adrianocprado/Comunica-o-Assistiva/docs/imagens/esp32.jpg

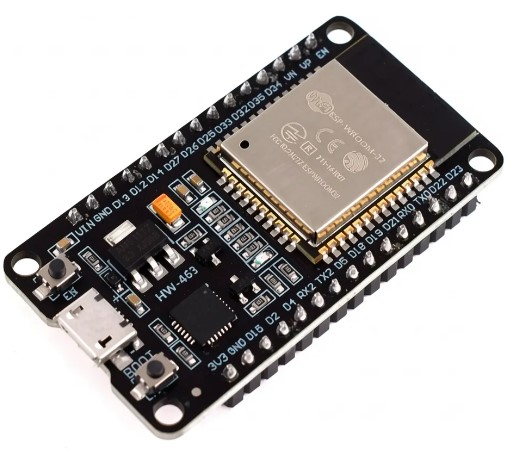
docs/imagens/esp32.jpg
