adrianocprado/Comunica-o-Assistiva/docs/imagens/etiquetarf.jpg

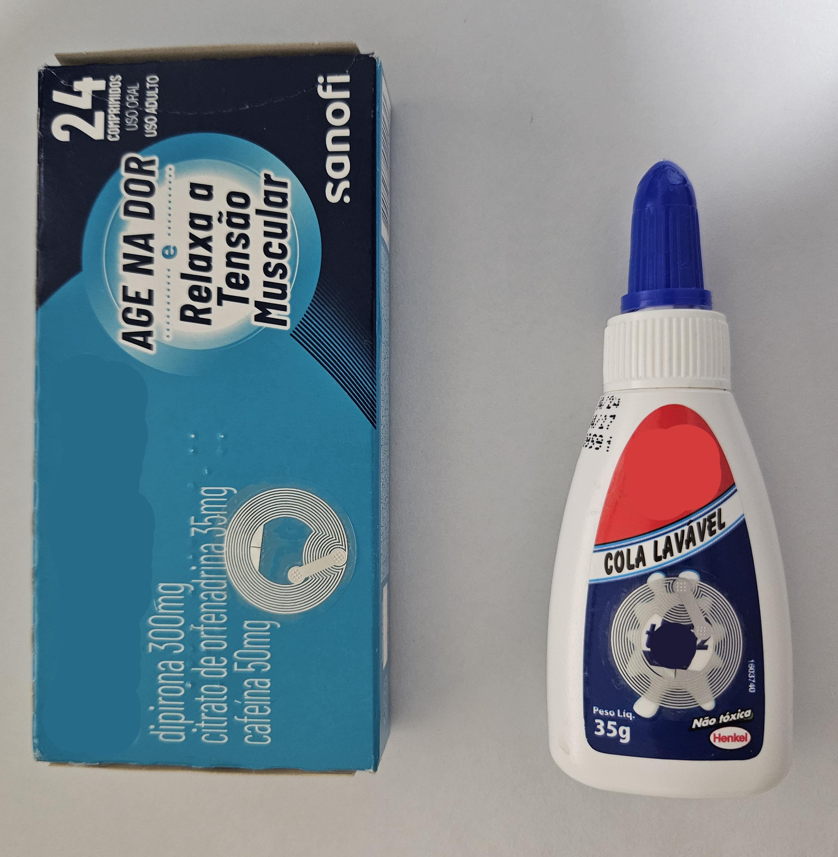
docs/imagens/etiquetarf.jpg
