adrianocprado/Comunica-o-Assistiva/docs/diagrama_esquematico_completo_j5019.pdf

# Manual Técnico e Diagrama Elétrico Unificado

Documentação de Suporte para Repositórios GitHub - Sistema Móvel Integrado

## 1. Diagrama Esquemático ASCII

O diagrama abaixo representa a integração completa entre a alimentação, gerenciamento de energia,
controle de fluxo por chave física e os módulos de processamento/periféricos do dispositivo.

======================================================================================== DIAGRAMA DE FLUXO ELÉTRICO COMPLETO — ECOSSISTEMA PORTÁTIL UNIFICADO ========================================================================================

[ ENTRADA DE ENERGIA ]
│
├──► (Via Cabo) ──────► [ Porta USB Tipo-C Integrada na Placa ]
| | │ | | | │
└──► (Alternativa) ───► [ Terminais IN+ / IN- ]
| | | | | │ ▼

┌────────────────────────────────────────────────────────────────────────────────┐
│ | MÓDULO INTEGRADO J5019 | │
│ | | | | | | | │
│ | [ Circuito de Carga ] | [ Circuito Regulador Step-Up ] │
│ | Modo: CC/CV (4.2V Max) | Ajuste por Trimpot (Ex: 5.0V) | │
│ | | | | | | | │
│ | BAT+ | BAT- | VOUT+ | VOUT- | │
└───────┬─────────────┬────────────────────────────────┬───────────────┬─────────┘
│ | │ | │ | │
▼ | ▼ | ▼ | │
┌─────┐ | ┌─────┐ | ┌───────┐ | │
│ (+) │ | │ (-) │ | │ CHAVE │ | │
└─────┘ | └─────┘ | │ LIGA/ │ | │
[ CÉLULA BATERIA 18650 ] | │ DESL. │ | │
(Lítio-Íon - 3.7V Nominal) | └───┬───┘ | │
│ | │
▼ | ▼
( 5V+ ) | ( GND )
│ | │
┌──────────────────────────────────────────────────────┴───────────────┴─────────┐
│ SISTEMA DO DISPOSITIVO (Exemplos de Carga Utilizável) | │
│ | | | | | | | │
│ | ┌───────────────────────────┐ | ┌───────────────────────────┐ | │
│ | │ | MICROCONTROLADOR | │ | │ | MÓDULOS PERIFÉRICOS | │ | │
│ | │ (Placa Arduino / ESP32) │ | │ (Sensores, Displays, etc)│ | │
│ | │ | | │ | │ | | │ | │
│ | │ | [ PINO 5V ] | [ PINO GND] | │ | [ PINO VCC ] [ PINO GND]│ | │
│ | └───▲─────────────▲─────────┘ | └───▲────────────▲──────────┘ | │
│ | │ | │ | │ | │ | │
│ | └─────────────┼────────────────────┴────────────┤ | │
└─────────────────────┼─────────────────────────────────┼────────────────────────┘ └─────────────────────────────────┘

## 2. Detalhamento das Conexões e Barramentos

Subcircuito de Armazenamento (Lítio): Os pinos BAT+ e BAT- conectam-se diretamente às extremidades correspondentes da célula 18650. Este barramento opera de maneira segura e independente, permitindo a recarga mesmo quando o dispositivo principal estiver desligado através da chave.

Controle de Fluxo (Chave Liga/Desliga): O terminal positivo elevado VOUT+ é direcionado de forma exclusiva a um dos terminais da chave de interrupção. A saída controlada da chave distribui os 5V estabilizados para o sistema.

Distribuição Geral (GND Comum e VCC): O barramento negativo de referência (GND) é unificado a partir do pino VOUT-, conectando-se ao pino GND do microcontrolador e à referência de todos os periféricos acoplados. A linha positiva de 5V alimenta simultaneamente os circuitos lógicos.

## 3. Procedimento Operacional Obrigatório

Ajuste Prévio de Tensão: Antes de efetuar a ligação definitiva das linhas de alimentação ao microcontrolador e sensores, conecte uma fonte à entrada (ou use a bateria conectada) e, com auxílio de um multímetro posicionado na escala de Corrente Contínua (DCV) acoplado aos fios de saída, rotacione o potenciômetro metálico integrativo até estabelecer o patamar estrito de 5.0V.

Isolamento e Segurança: Verifique se todas as conexões soldadas estão devidamente protegidas com espaguete termoretrátil para mitigar riscos de curto-circuito mecânico dentro do invólucro do dispositivo.

Este arquivo foi gerado para documentação de projetos eletrônicos de código aberto. Verifique sempre as polaridades e as conexões antes de energizar o circuito.

•

•

•

1.

2.
