adrianocprado/Comunica-o-Assistiva/docs/imagens/altofalante4o3w.jpg

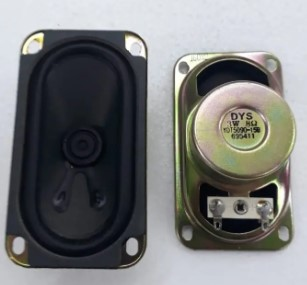
docs/imagens/altofalante4o3w.jpg
