adrianocprado/Comunica-o-Assistiva/docs/imagens/amplificadormax98357.jpg

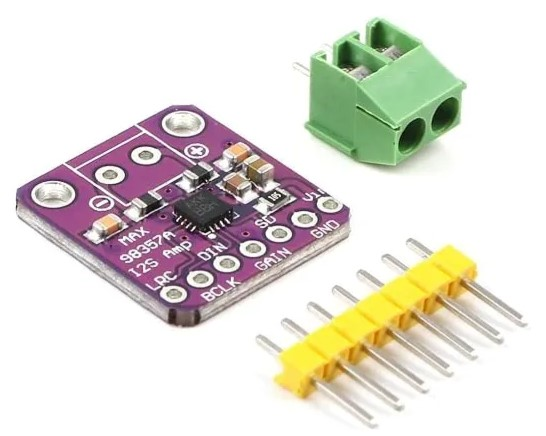
docs/imagens/amplificadormax98357.jpg
