adrianocprado/Comunica-o-Assistiva/docs/imagens/bateria18650.jpg

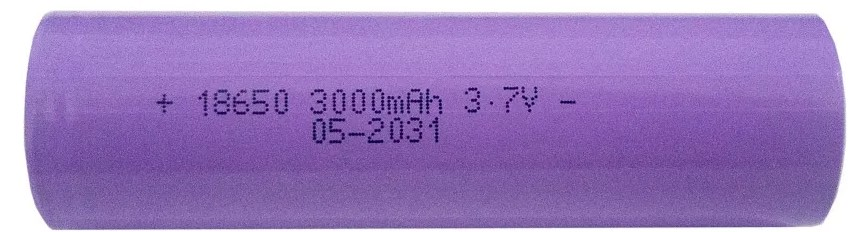
docs/imagens/bateria18650.jpg
