adrianocprado/Comunica-o-Assistiva/docs/imagens/caixa.jpg

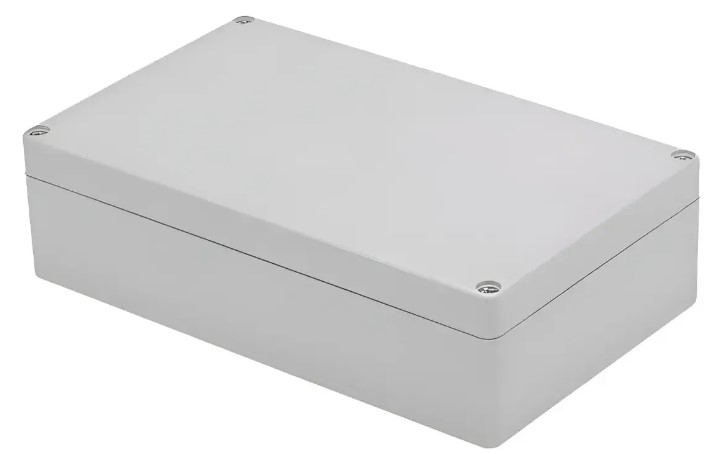
docs/imagens/caixa.jpg
