adrianocprado/Comunica-o-Assistiva/docs/imagens/cartaorfid.jpg

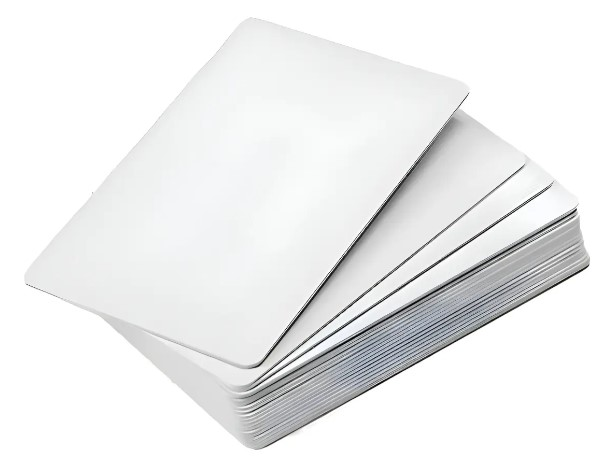
docs/imagens/cartaorfid.jpg
