adrianocprado/Comunica-o-Assistiva/docs/imagens/cartoesrfid.jpg

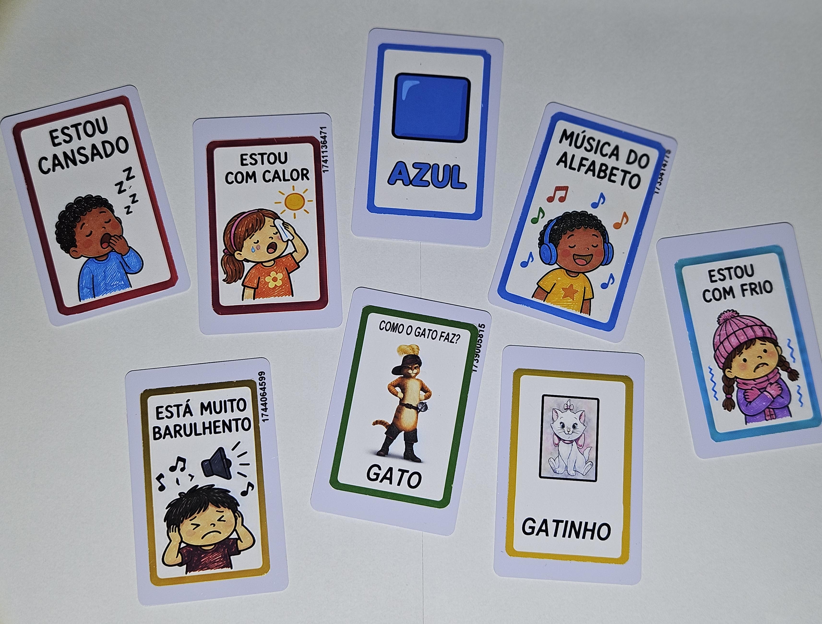
docs/imagens/cartoesrfid.jpg
