adrianocprado/Comunica-o-Assistiva/docs/imagens/chaveligadesliga.jpg

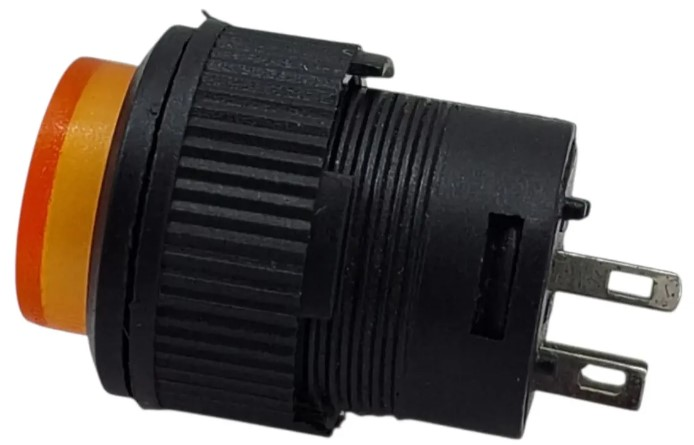
docs/imagens/chaveligadesliga.jpg
