adrianocprado/Comunica-o-Assistiva/docs/imagens/conectortipoc.jpg

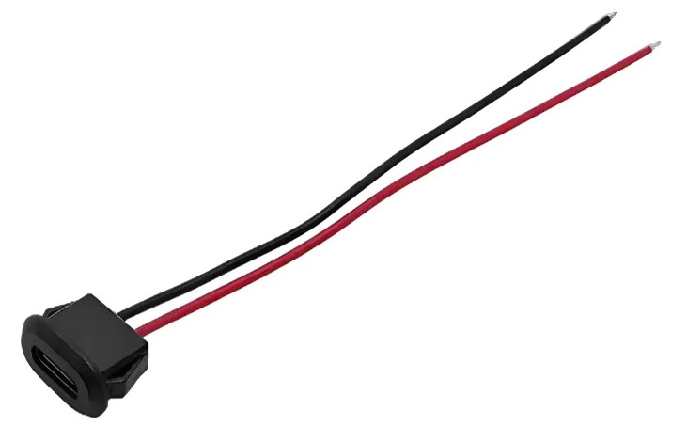
docs/imagens/conectortipoc.jpg
