adrianocprado/Comunica-o-Assistiva/docs/imagens/displaytft18.jpg

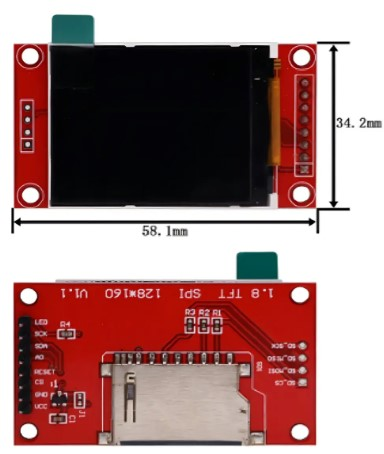
docs/imagens/displaytft18.jpg
