adrianocprado/Comunica-o-Assistiva/docs/imagens/etiquetanfc.jpg

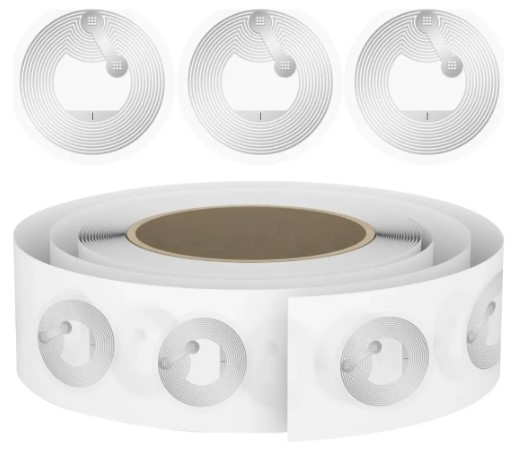
docs/imagens/etiquetanfc.jpg
