adrianocprado/Comunica-o-Assistiva/docs/imagens/ETIQUETAS.jpg

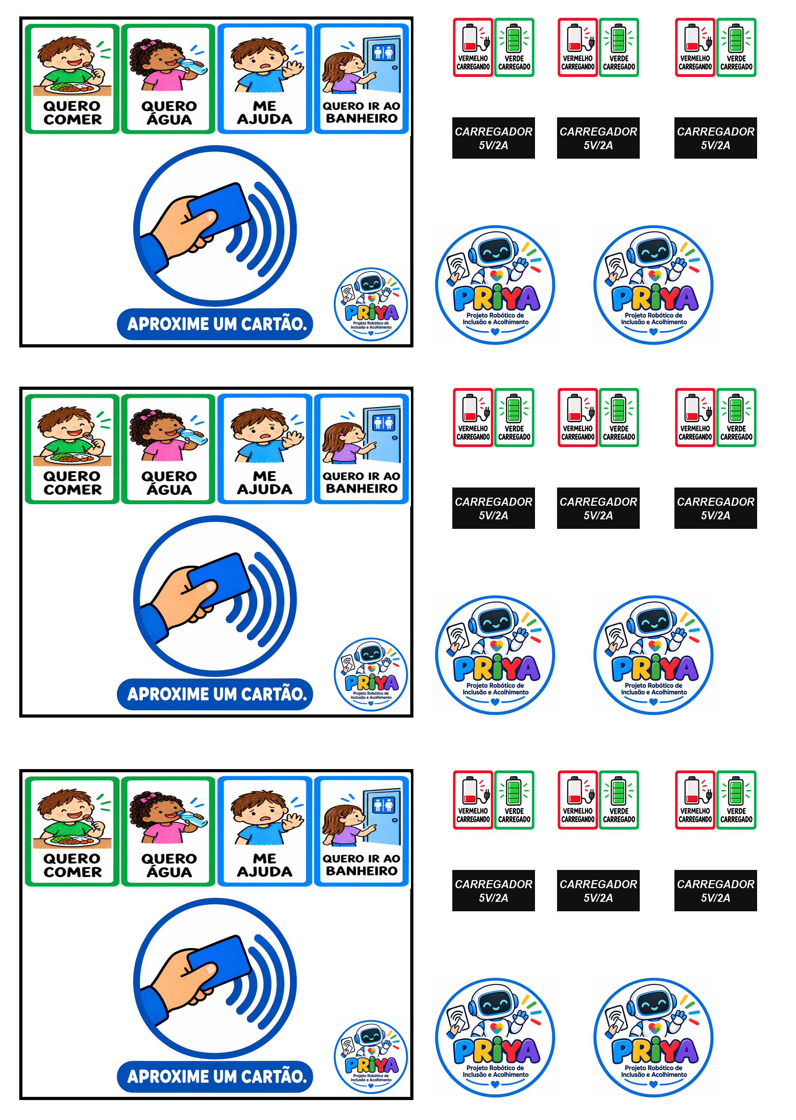
docs/imagens/ETIQUETAS.jpg
