adrianocprado/Comunica-o-Assistiva/docs/imagens/finalizado2.jpg

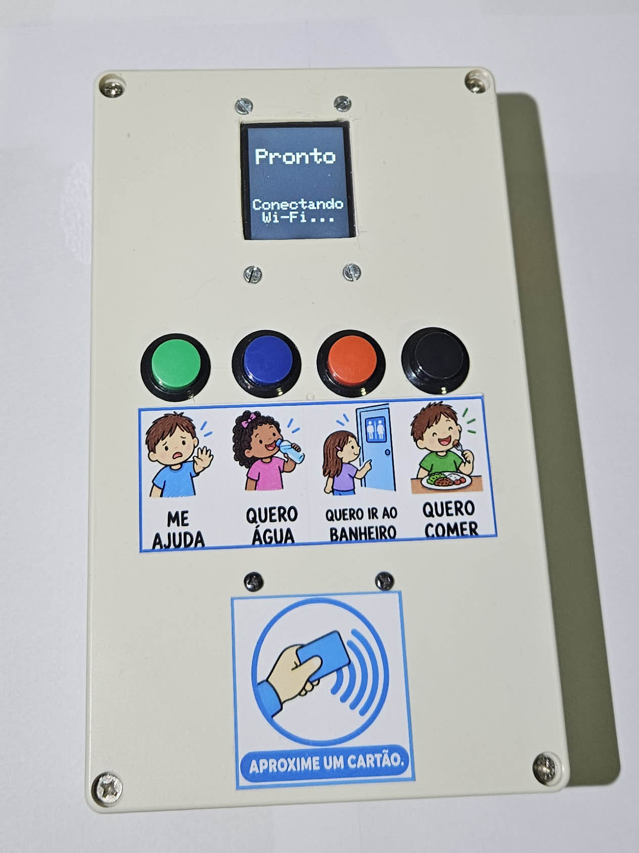
docs/imagens/finalizado2.jpg
