adrianocprado/Comunica-o-Assistiva/docs/imagens/finalizado.jpg

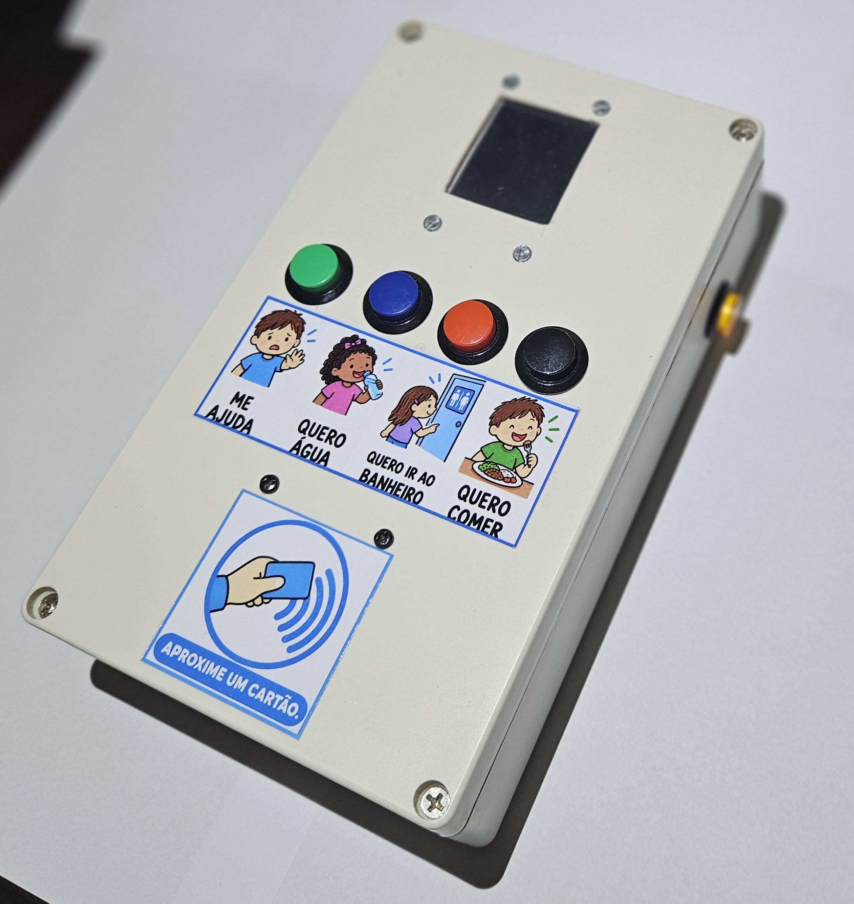
docs/imagens/finalizado.jpg
