adrianocprado/Comunica-o-Assistiva/docs/imagens/montado5.jpg

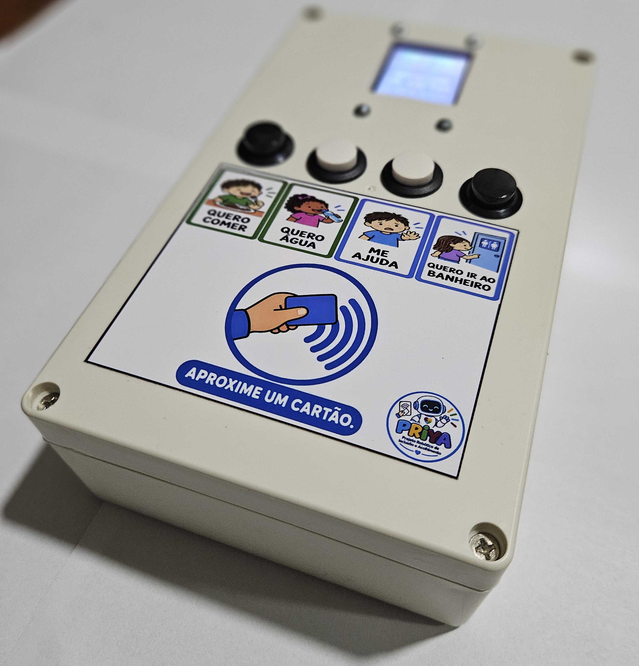
docs/imagens/montado5.jpg
