adrianocprado/Comunica-o-Assistiva/docs/imagens/montado6.jpg

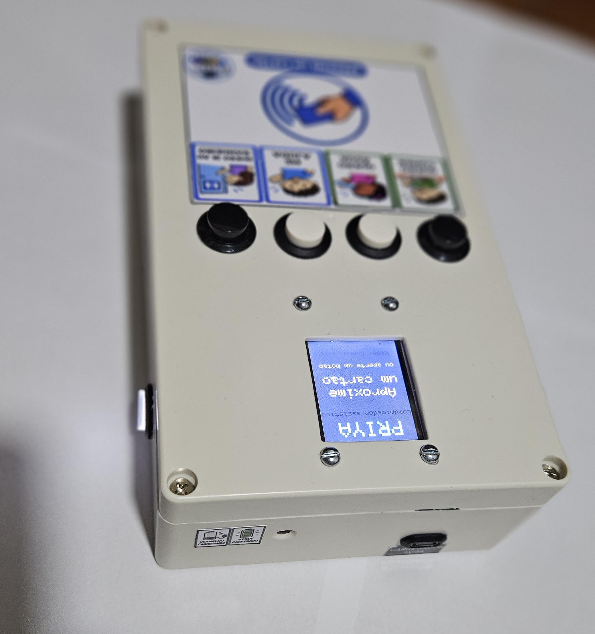
docs/imagens/montado6.jpg
