adrianocprado/Comunica-o-Assistiva/docs/imagens/montado7.jpg

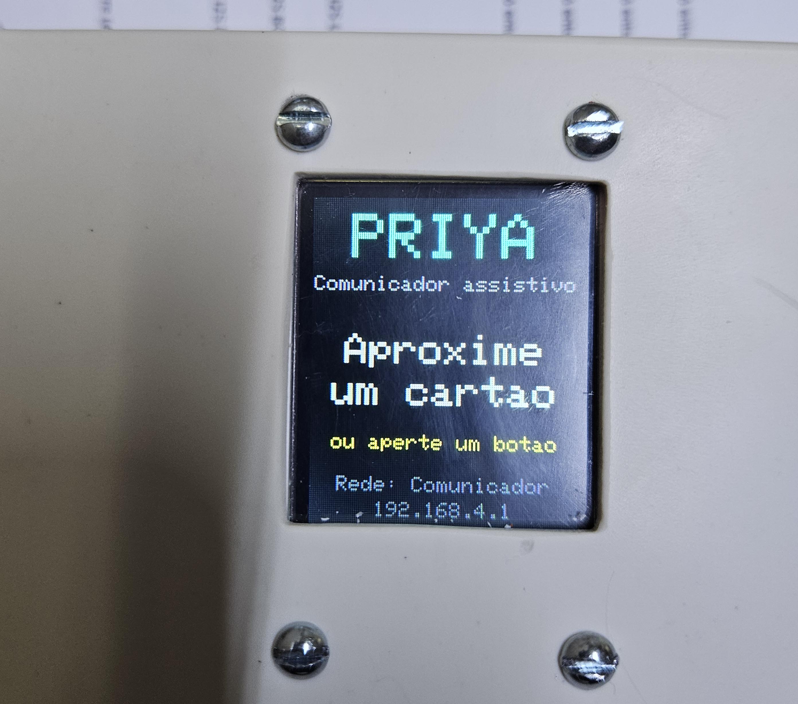
docs/imagens/montado7.jpg
