adrianocprado/Comunica-o-Assistiva/docs/imagens/montado8.jpg

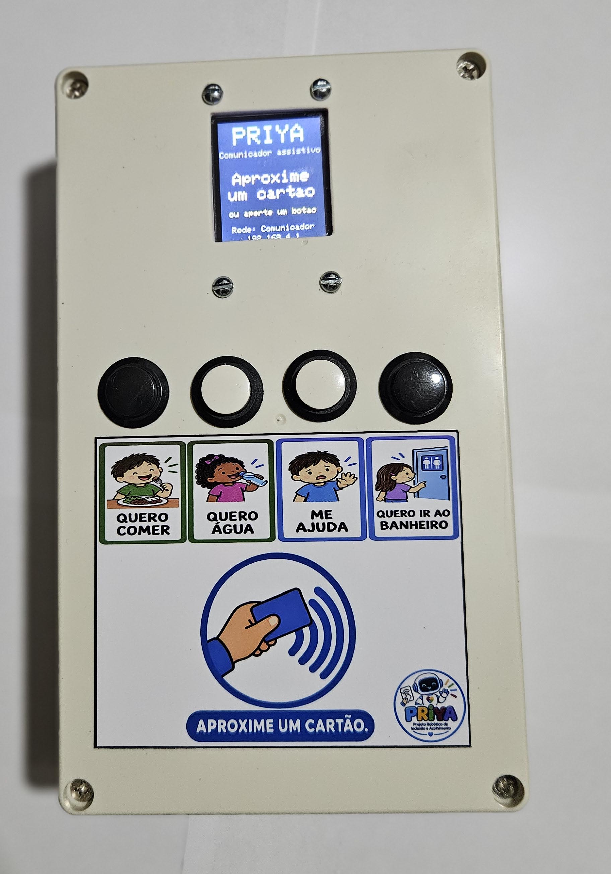
docs/imagens/montado8.jpg
