adrianocprado/Comunica-o-Assistiva/docs/imagens/montado 7.jpg

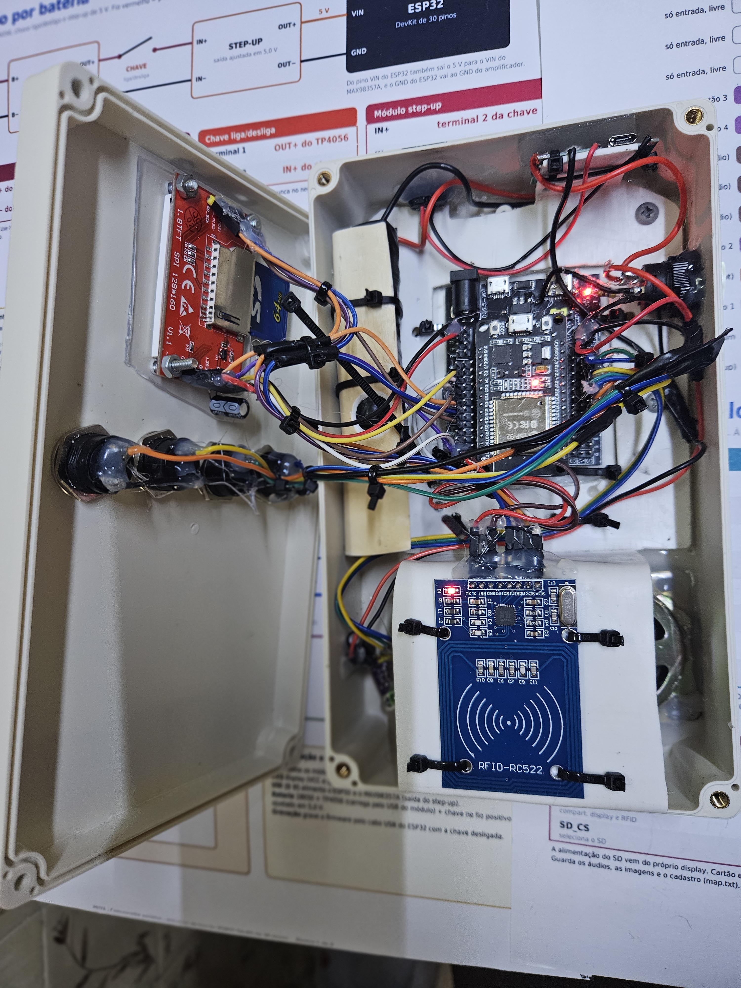
docs/imagens/montado 7.jpg
