adrianocprado/Comunica-o-Assistiva/docs/imagens/montando1.jpg

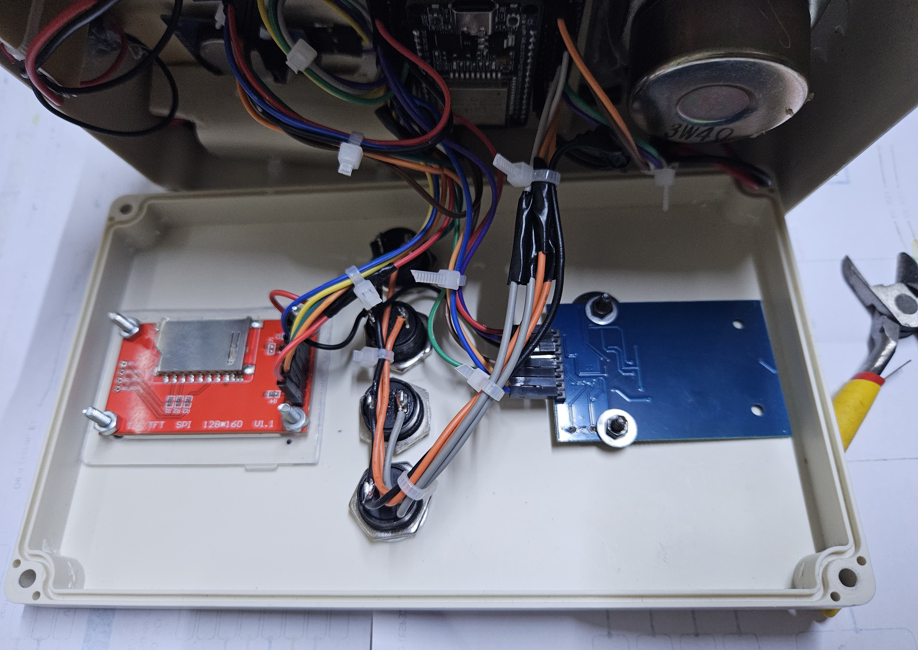
docs/imagens/montando1.jpg
