adrianocprado/Comunica-o-Assistiva/docs/imagens/montando5.jpg

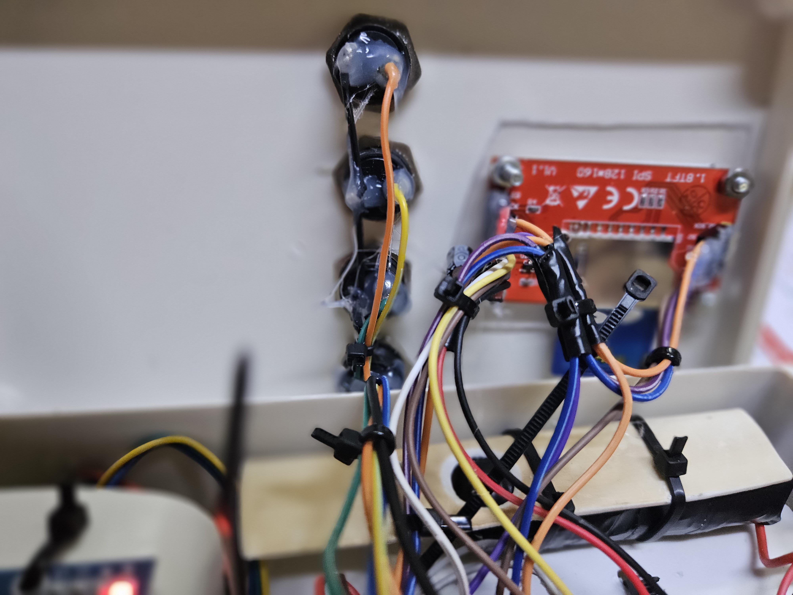
docs/imagens/montando5.jpg
