adrianocprado/Comunica-o-Assistiva/docs/imagens/montando6.jpg

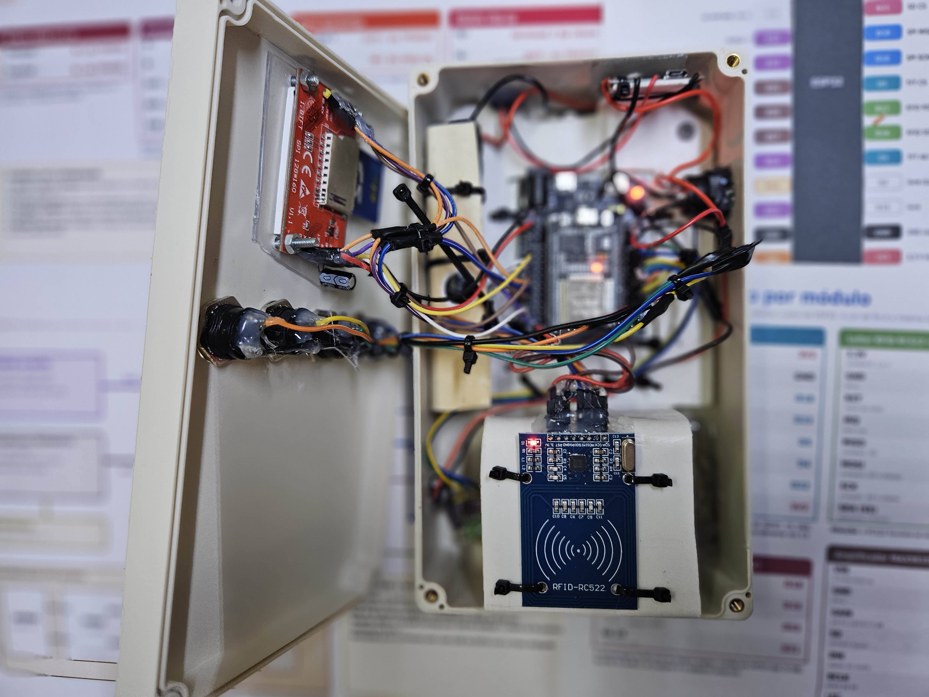
docs/imagens/montando6.jpg
