adrianocprado/Comunica-o-Assistiva/docs/imagens/painel1.jpg

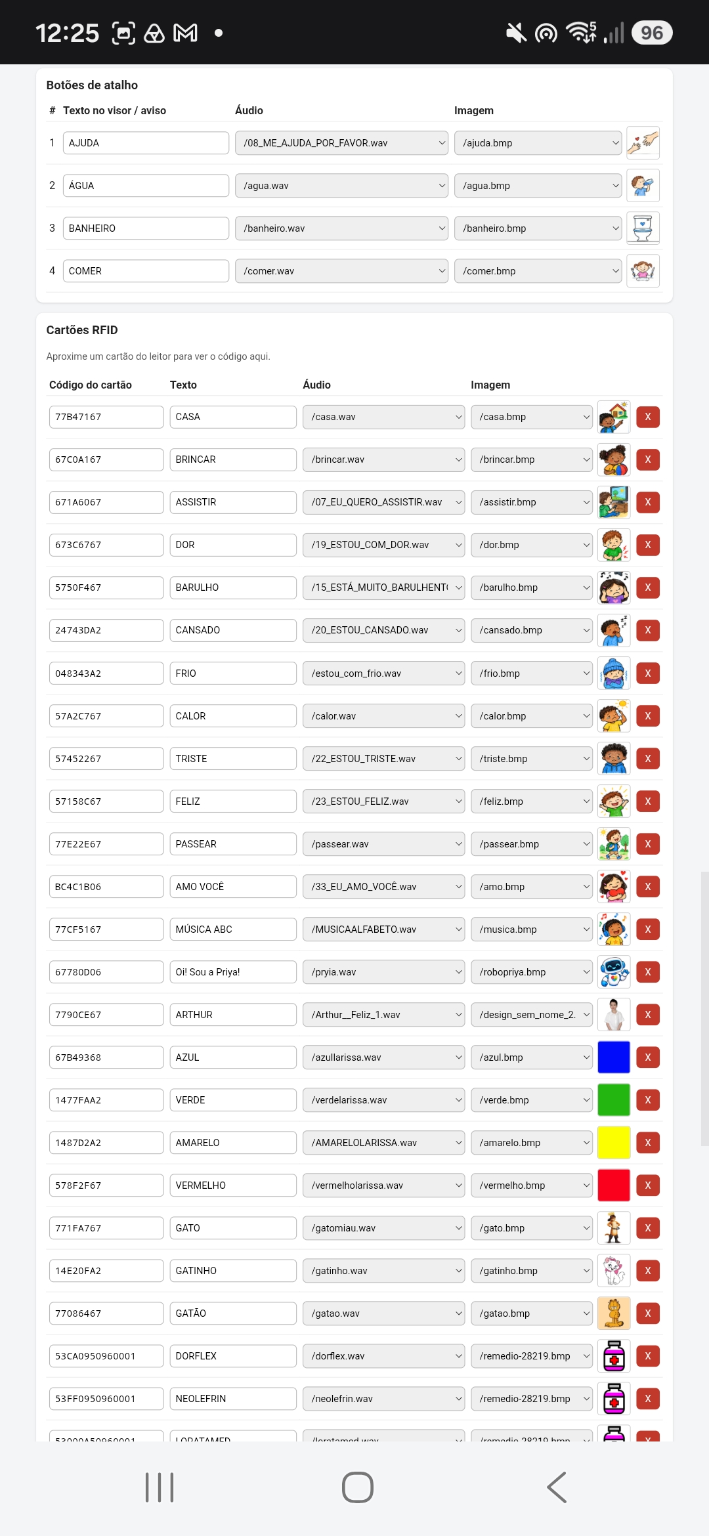
docs/imagens/painel1.jpg
