adrianocprado/Comunica-o-Assistiva/docs/imagens/painel2.jpg

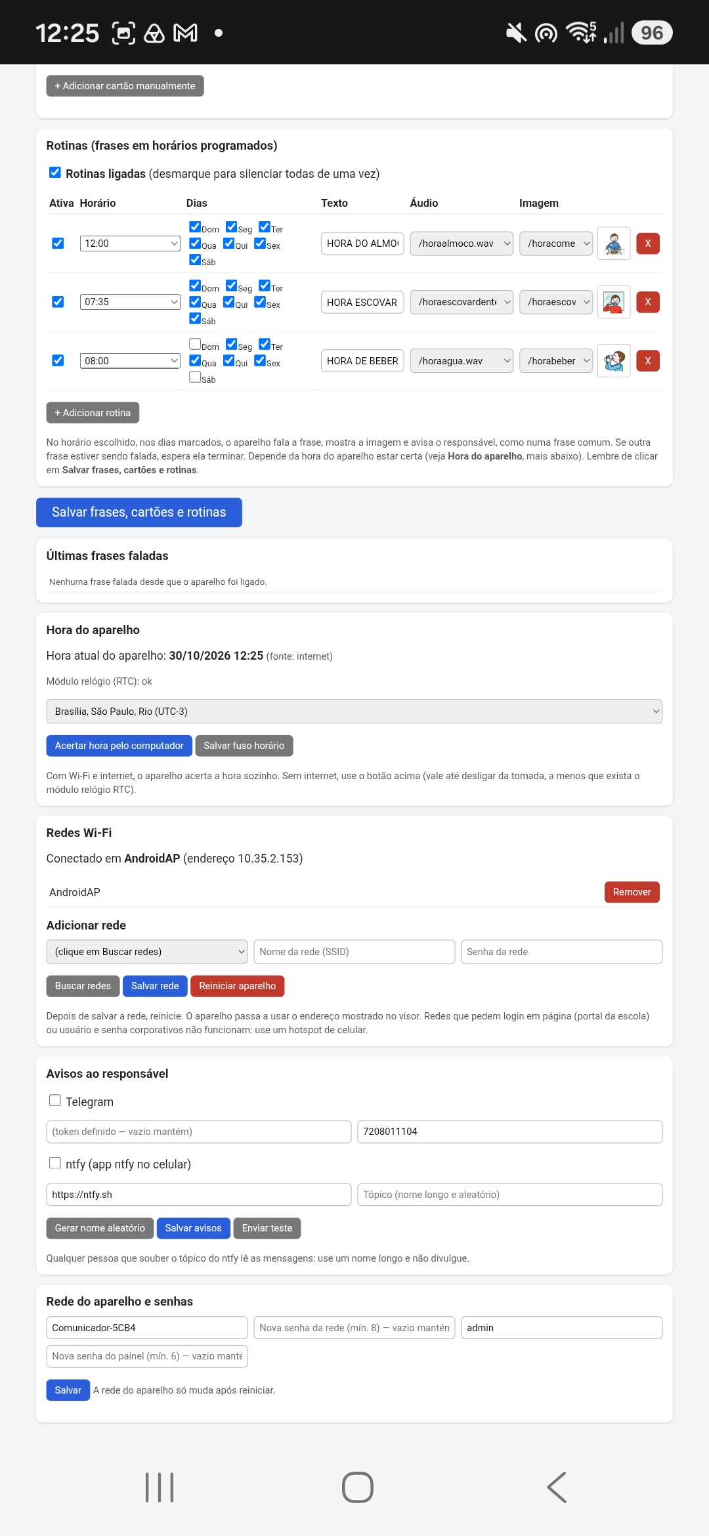
docs/imagens/painel2.jpg
