adrianocprado/Comunica-o-Assistiva/docs/imagens/pushbuttonr13.jpg

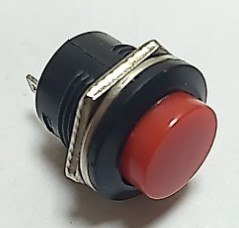
docs/imagens/pushbuttonr13.jpg
