adrianocprado/Comunica-o-Assistiva/docs/imagens/rfidrc522.jpg

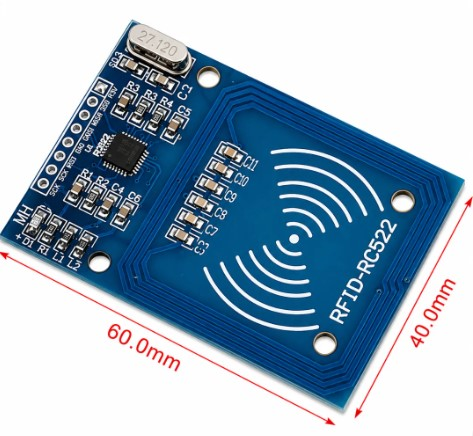
docs/imagens/rfidrc522.jpg
