adrianocprado/Comunica-o-Assistiva/docs/imagens/stepup5019.jpg

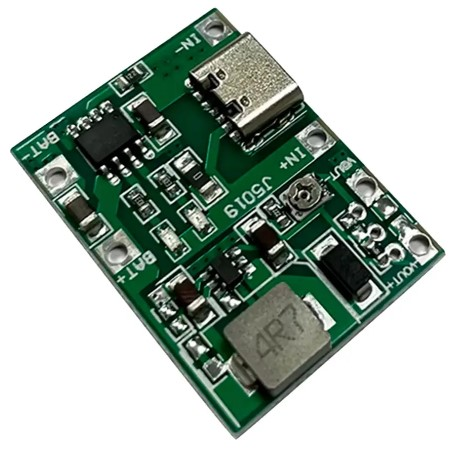
docs/imagens/stepup5019.jpg
