adrianocprado/Comunica-o-Assistiva/docs/esquema_em_blocos_comunicador.pdf

# Comunicador assistivo - Esquema em blocos

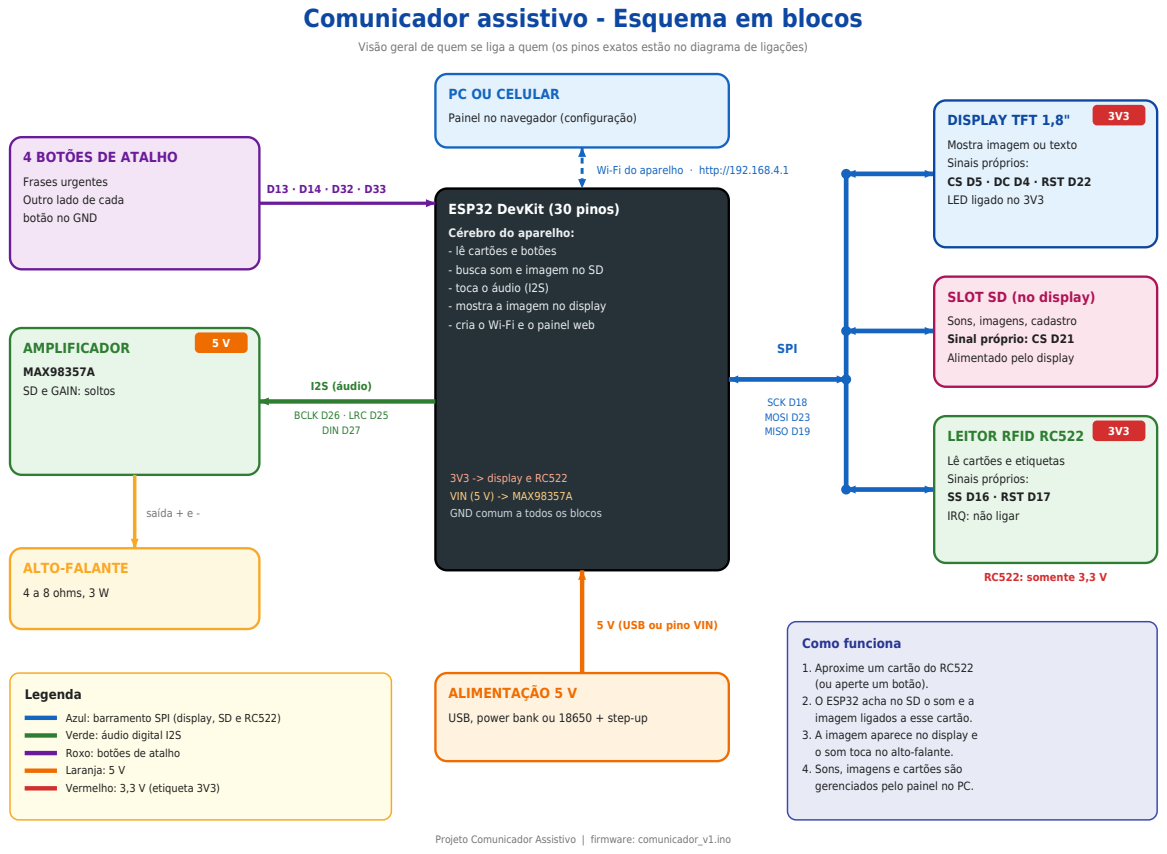
[picture p35: page 1]

Visão geral de quem se liga a quem (os pinos exatos estão no diagrama de ligações)

Painel no navegador (configuração)

Mostra imagem ou texto
Sinais próprios:
CS D5 · DC D4 · RST D22
LED ligado no 3V3

Frases urgentes
Outro lado de cada
botão no GND

Wi-Fi do aparelho · http://192.168.4.1

Cérebro do aparelho:
- lê cartões e botões
- busca som e imagem no SD
- toca o áudio (I2S)
- mostra a imagem no display
- cria o Wi-Fi e o painel web

SLOT SD (no display)

3V3 -> display e RC522
VIN (5 V) -> MAX98357A
GND comum a todos os blocos

5 V (USB ou pino VIN)

1. Aproxime um cartão do RC522
(ou aperte um botão).
2. O ESP32 acha no SD o som e a
imagem ligados a esse cartão.
3. A imagem aparece no display e
o som toca no alto-falante.
4. Sons, imagens e cartões são
gerenciados pelo painel no PC.

Azul: barramento SPI (display, SD e RC522)
Verde: áudio digital I2S
Roxo: botões de atalho
Laranja: 5 V
Vermelho: 3,3 V (etiqueta 3V3)

USB, power bank ou 18650 + step-up

Projeto Comunicador Assistivo | firmware: comunicador_v1.ino
