adrianocprado/Comunica-o-Assistiva/docs/tabelas_ligacao_comunicador.pdf

# Comunicador assistivo - Ligações por módulo

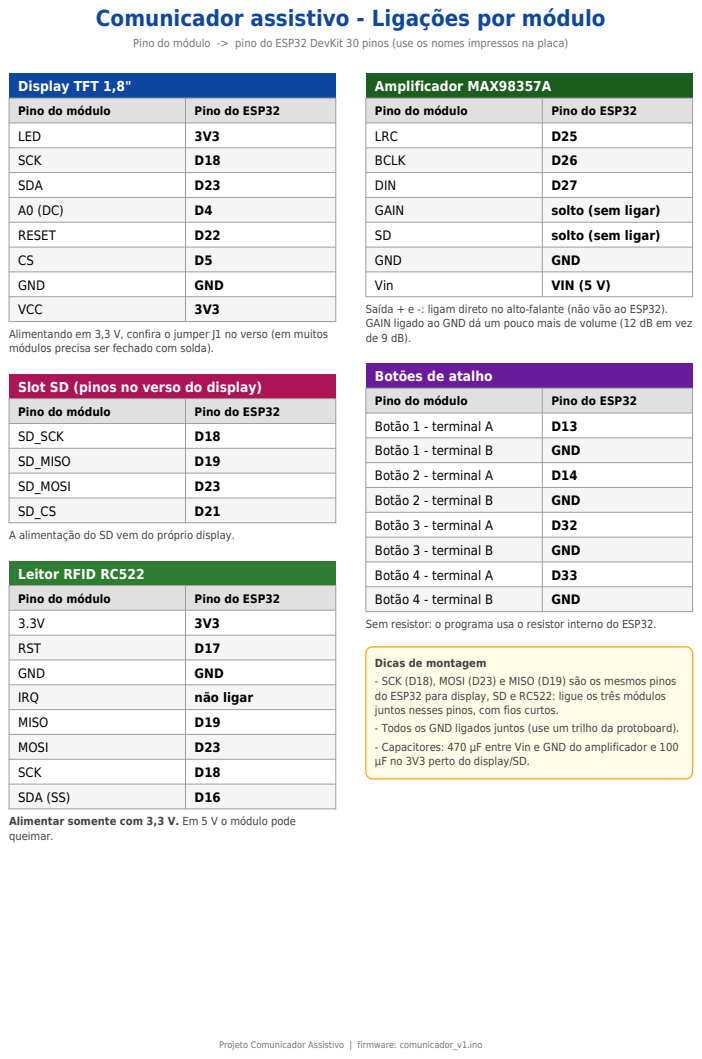
[picture p36: page 1]

Pino do módulo -> pino do ESP32 DevKit 30 pinos (use os nomes impressos na placa)

Saída + e -: ligam direto no alto-falante (não vão ao ESP32).
GAIN ligado ao GND dá um pouco mais de volume (12 dB em vez

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

Slot SD (pinos no verso do display)

Pino do módulo | Pino do ESP32
Botão 1 - terminal A | D13

SD_SCK | D18

Botão 1 - terminal B | GND

SD_MISO | D19

Botão 2 - terminal A | D14

SD_MOSI | D23

Botão 2 - terminal B | GND

Botão 3 - terminal A | D32

A alimentação do SD vem do próprio display.

Botão 3 - terminal B | GND

Botão 4 - terminal A | D33

Sem resistor: o programa usa o resistor interno do ESP32.

RST | D17

GND | GND
IRQ | não ligar

Dicas de montagem
- SCK (D18), MOSI (D23) e MISO (D19) são os mesmos pinos
do ESP32 para display, SD e RC522: ligue os três módulos
juntos nesses pinos, com fios curtos.
- Todos os GND ligados juntos (use um trilho da protoboard).
- Capacitores: 470 µF entre Vin e GND do amplificador e 100
µF no 3V3 perto do display/SD.

MISO | D19

MOSI | D23

SCK | D18

SDA (SS) | D16

Alimentar somente com 3,3 V. Em 5 V o módulo pode
queimar.

Projeto Comunicador Assistivo | firmware: comunicador_v1.ino
